quevedol/tiny/(commit log)

2026-09-27 Stabilize Sky130 gate-level pin checks
2026-09-28 Report gate-level pin values clearly
2026-09-28 Power Sky130 gate-level testbench in 3x2
2026-09-28 Add board-level testbench and Spanish test report
    tb_board.v drives the Tiny Tapeout top module through its pins with the
    production parameters (50 MHz, 115200 baud, 12.5 MHz SCK) and the serial
    Flash/PSRAM model on uio. test_board.py checks reset-safe pins, the first
    Flash READ command, a full boot decoded from uo[0] (SML1), ena=0 and a
    reset in the middle of the boot. Makefile.board also runs the same tests
    on a gate-level netlist. The CI test job now runs it.
    The report PDF documents the RTL and gate-level runs, Sky130 synthesis
    area, a timing estimate and what could not be tested here. The guide
    PDF is corrected: uo[5] is the sticky MMIO done bit, not a 1-cycle pulse.
2026-09-28 Close 3x2 timing: drop SERV clock gate, split MAC accumulate
    The 3x2 hardening routed cleanly (DRC, LVS, antenna pass) but stopped on
    hold violations in the ff corners, with setup violations in ss. The gated
    SERV clock (1191 sinks behind the ICG) and the ungated clk formed two
    domains with large skew; 725 hold buffers did not recover it.
    SERV already stalls on its Wishbone ack, so the gate is unnecessary: the
    full boot from serial Flash/PSRAM and all board tests pass with SERV on
    clk. Removing it leaves one clock domain. The pause test now checks the
    bus-stall contract instead (stable request, no early ack, one ack).
    The MAC registers the signed product and accumulates it one cycle later,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
2026-09-28 Repair only real hold before routing in 3x2; align docs with 3x2
    Without the gated SERV clock, post-CTS STA shows no setup violations and
    a worst hold slack of only -0.047 ns. The 0.1 ns pre-route hold margin
    then made the resizer insert 1590 hold buffers (+17.9% area) and detailed
    placement failed (DPL-0036). Return PL_RESIZER_HOLD_SLACK_MARGIN to 0.0
    and keep the 0.05 ns post-route margin.
    README and PROJECT_GUIDE now state the 3x2 size, the removal of the SERV
    clock gate and the nine-cycle MAC.
2026-09-28 Raise post-route hold margin to 0.1 ns for 3x2 closure
    Run 6 closed setup in every corner (worst +0.22 ns, max_ss) and passed
    DRC, LVS and antenna checks, but five SERV shift-register paths missed
    hold by up to 11 ps in the ff corners after detailed routing. The 0.05 ns
    guardband applied after global routing does not cover the change from
    detailed routing, so raise GRT_RESIZER_HOLD_SLACK_MARGIN to 0.1 ns.
    The Timing summary step also prints the resizer hold-repair results and
    the final area/utilization metrics.
2026-09-29 Record 3x2 closure results and publish final Spanish reports
    Commit c853560 passed gds, precheck and gl_test: DRC, LVS and antenna
    clean, hold closed in all nine corners, 82.9% utilization. One path is
    9.5 ps short on setup in max_ss_100C_1v60 (warning only). The 76 hold
    buffers come from the 0.02 ns post-CTS margin; the post-GRT resizer ran
    and found nothing to repair.
    SKY130_MIGRATION, TASKS and PROJECT_GUIDE record the results. docs/ now
    holds the updated beginner guide, the final test report and a two-page
    summary of the changes.
2026-10-27 Add the QvIC Labs logo as met4 silicon art
    Generated from macro_generation/qvic_logo.png by macro_generation/qvic_logo.py
    (0.5 um pixels, 32 x 14.5 um macro) and placed between two met4 power-stripe
    pairs on the bottom edge, following the Tiny Tapeout silicon-art guide.
